j3rgus/soc/Príloha 2/P1080830.JPG

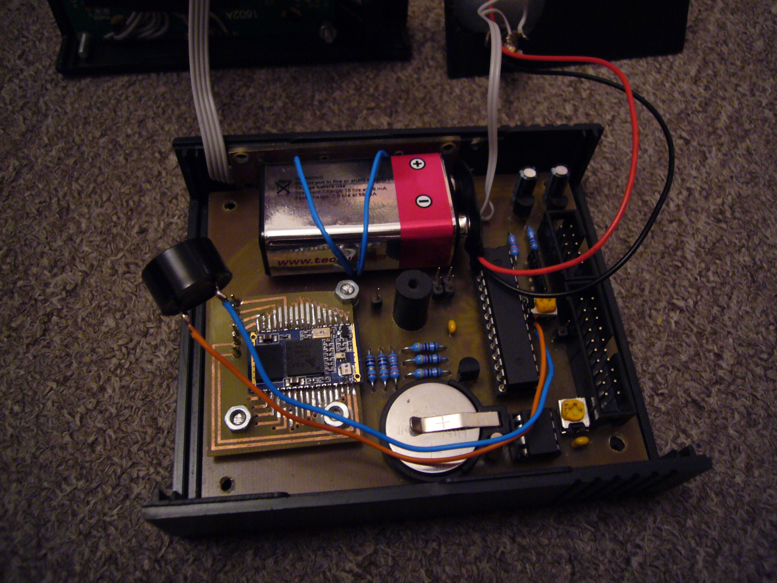
Príloha 2/P1080830.JPG
