j3rgus/soc/Príloha 2/P1080827.JPG

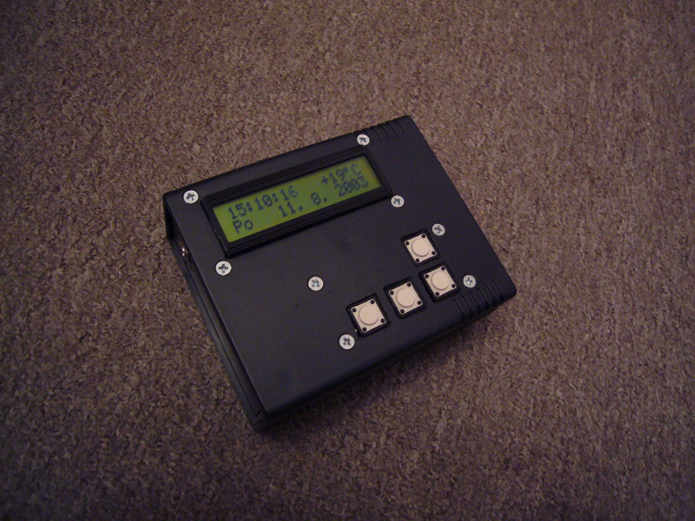
Príloha 2/P1080827.JPG
