j3rgus/soc/Príloha 2/dps.bmp

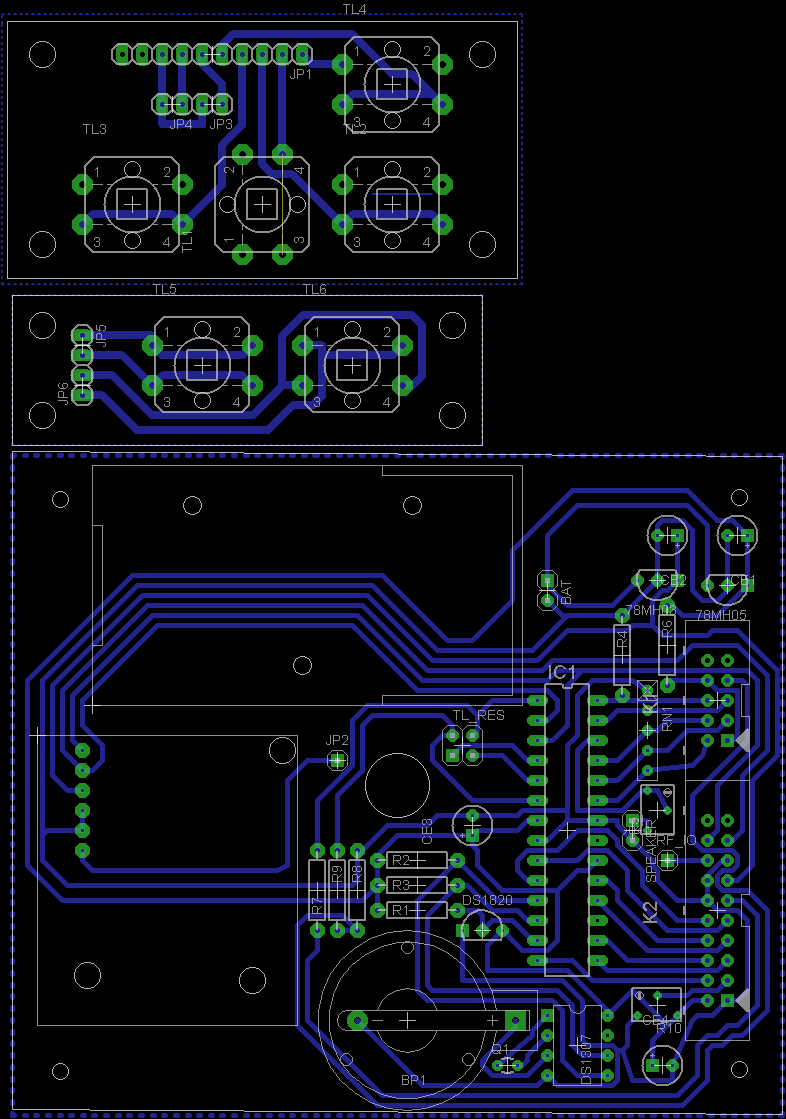
Príloha 2/dps.bmp
