j3rgus/soc/Príloha 2/P1080824.JPG

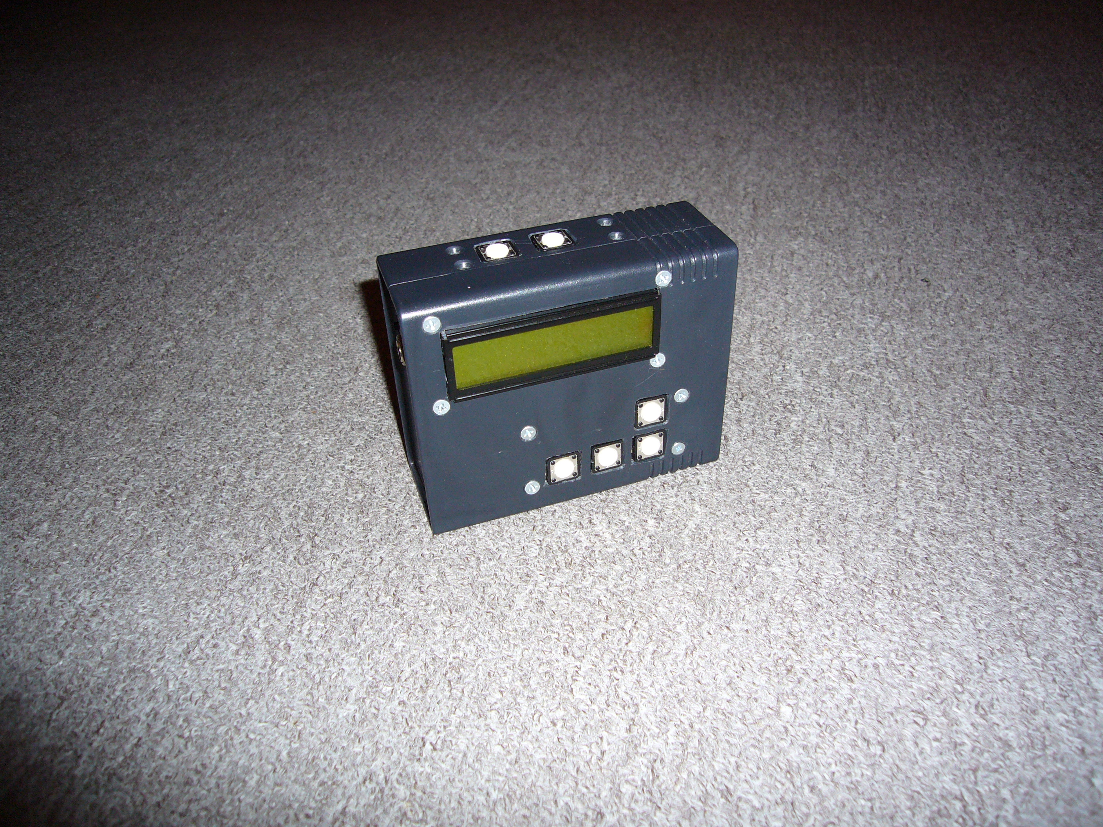
Príloha 2/P1080824.JPG
