j3rgus/soc/Príloha 2/P1080825.JPG

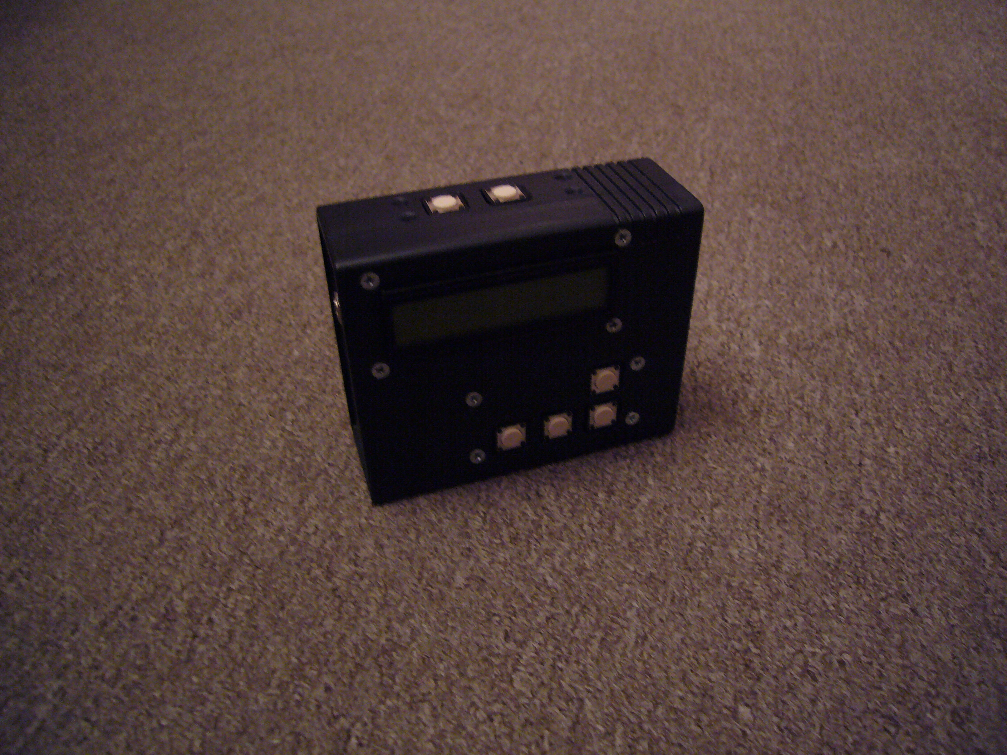
Príloha 2/P1080825.JPG
