j3rgus/soc/Príloha 2/P1080826.JPG

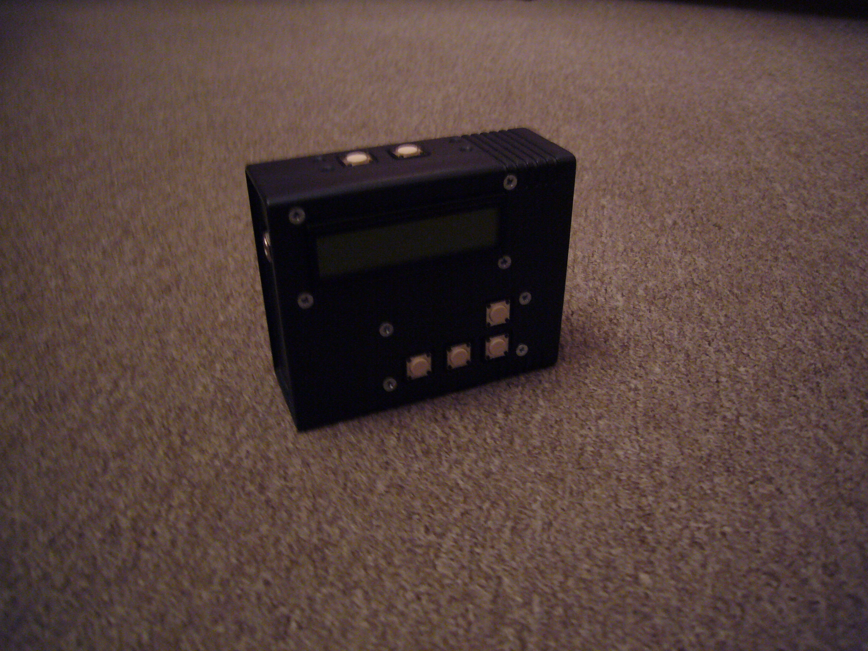
Príloha 2/P1080826.JPG
