j3rgus/soc/Príloha 2/P1080828.JPG

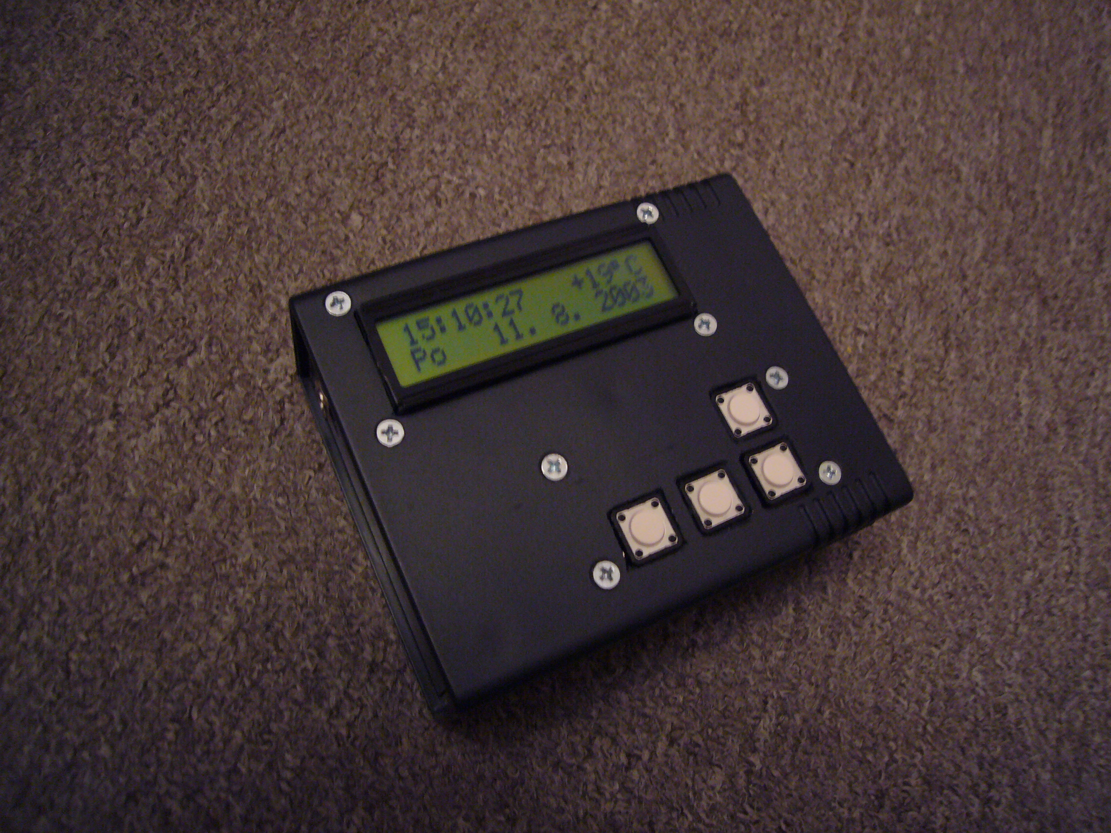
Príloha 2/P1080828.JPG
