j3rgus/soc/Príloha 2/P1080829.JPG

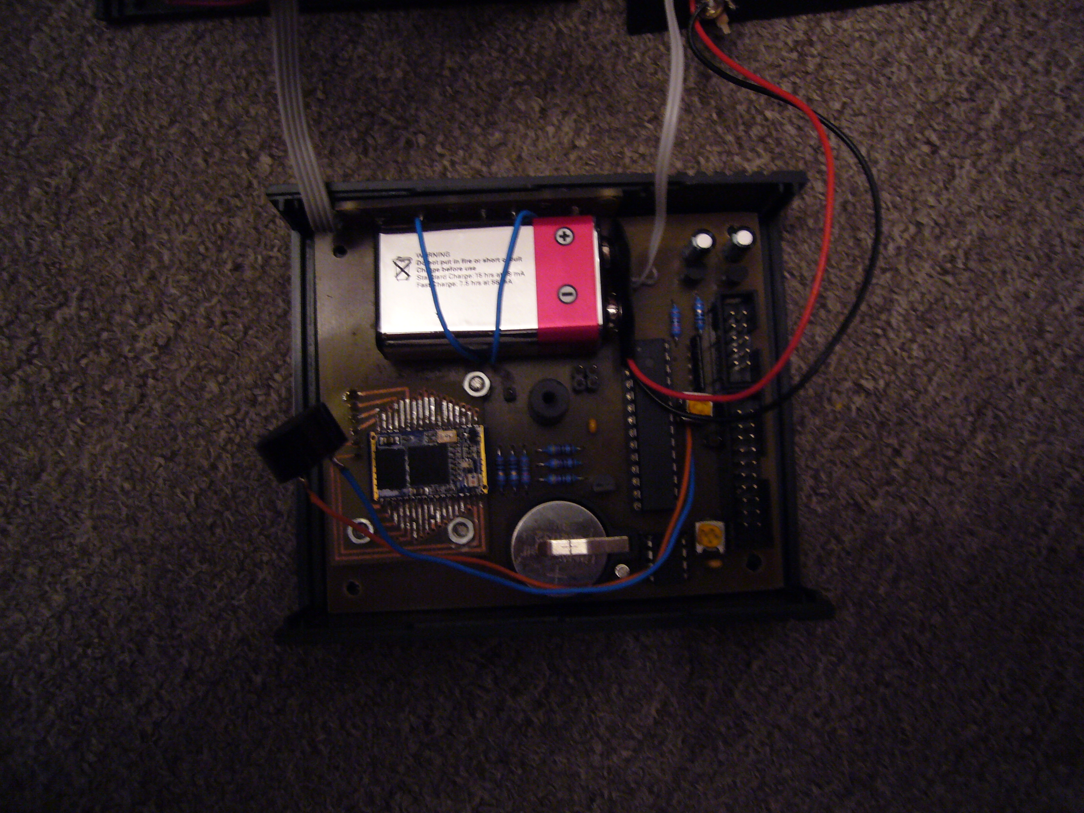
Príloha 2/P1080829.JPG
