j3rgus/soc/Príloha 2/P1080831.JPG

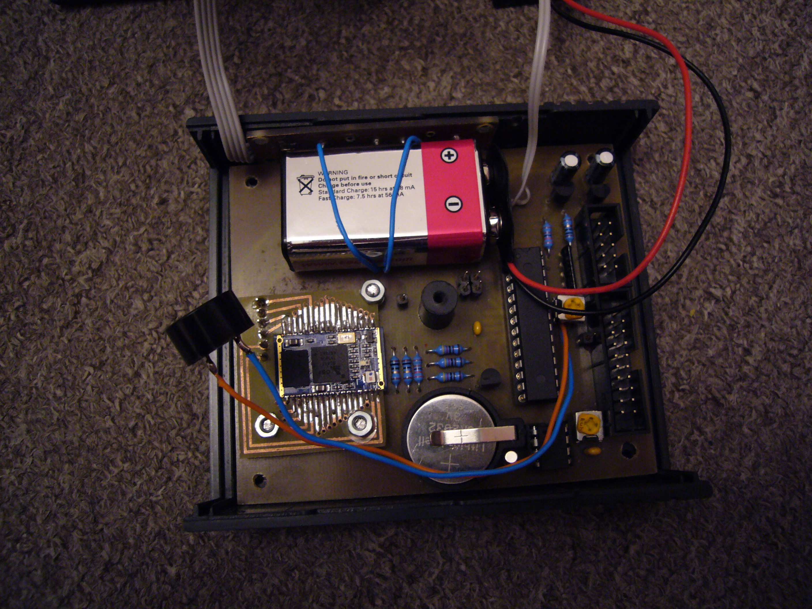
Príloha 2/P1080831.JPG
