j3rgus/soc/Príloha 2/P1080832.JPG

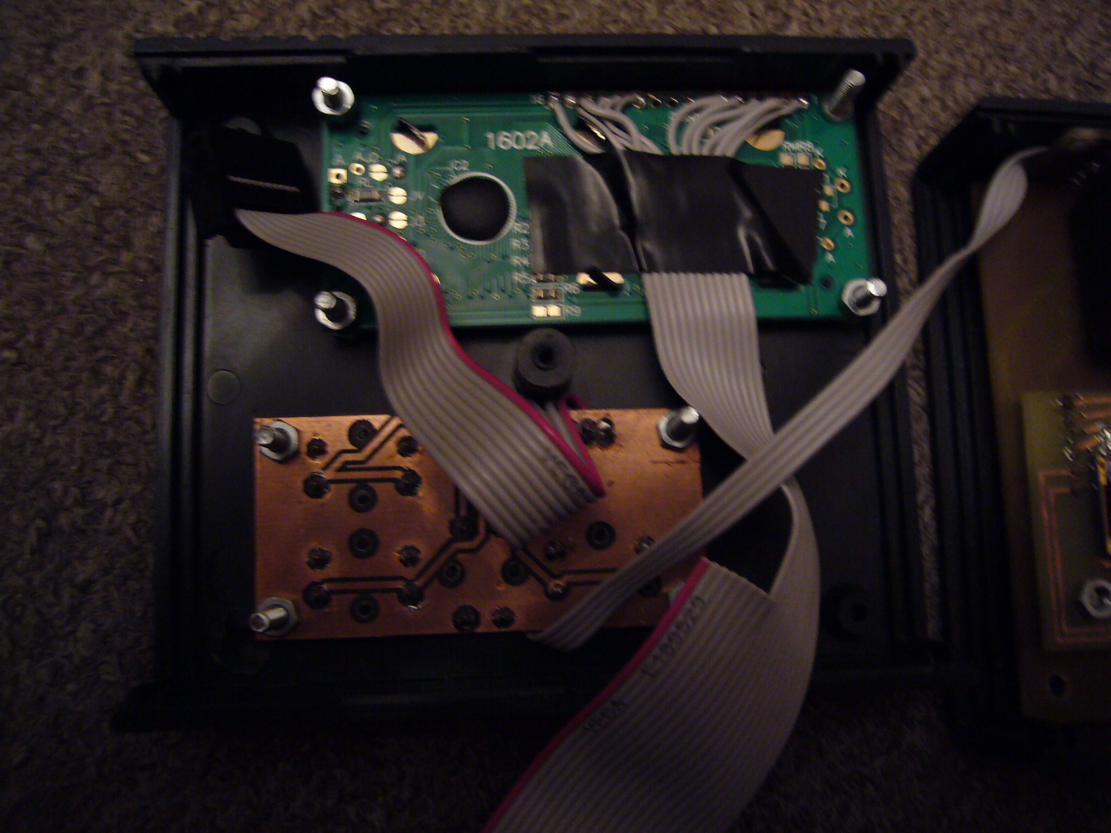
Príloha 2/P1080832.JPG
