j3rgus/soc/Príloha 2/P1080833.JPG

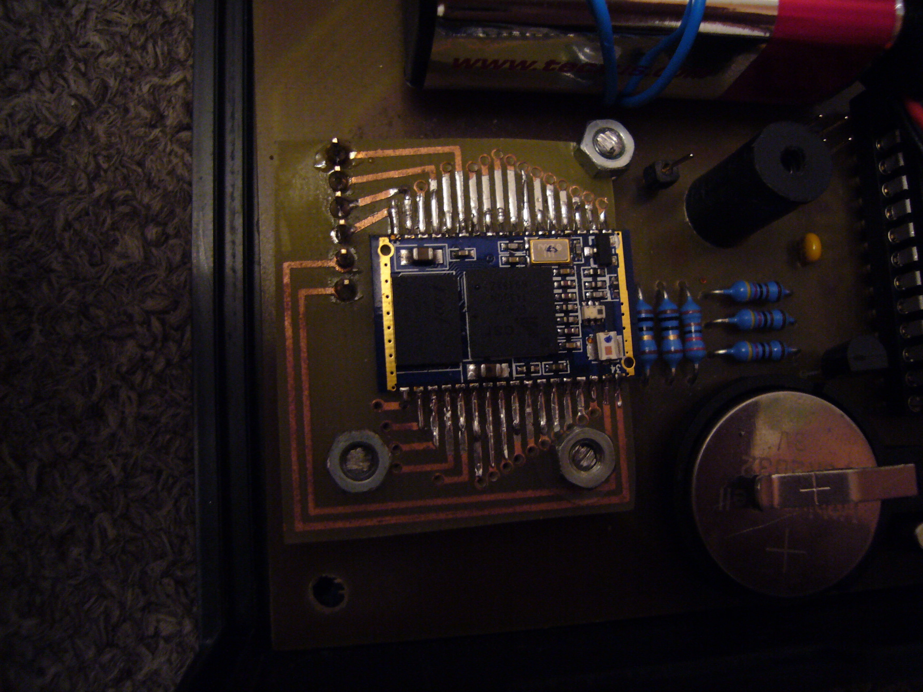
Príloha 2/P1080833.JPG
