j3rgus/soc/Príloha 2/P1080834.JPG

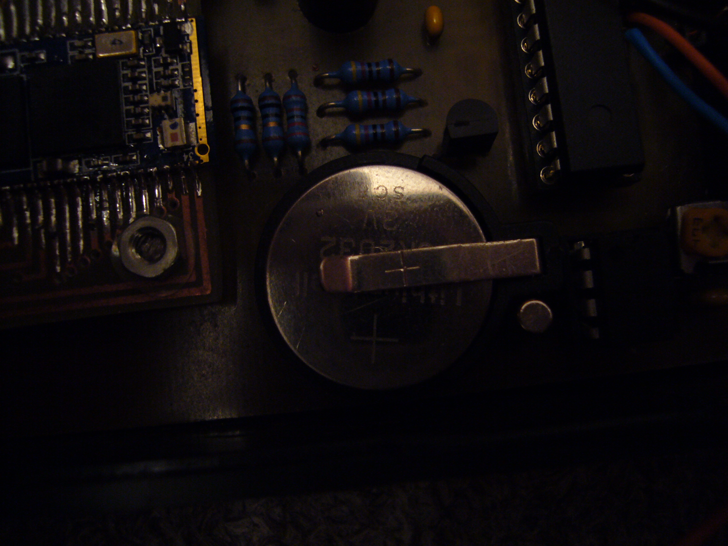
Príloha 2/P1080834.JPG
