j3rgus/soc/Príloha 2/P1080837.JPG

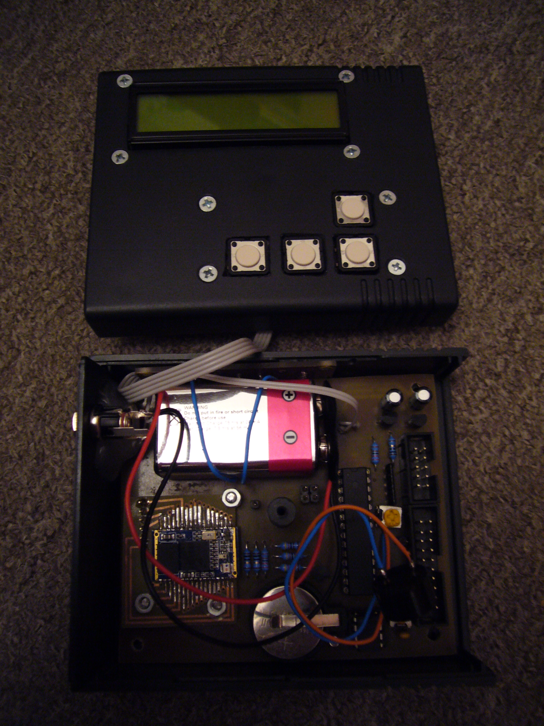
Príloha 2/P1080837.JPG
